kittengineering/MJS2020/Documents/Blockdiagram_MJS_Rev4.pdf

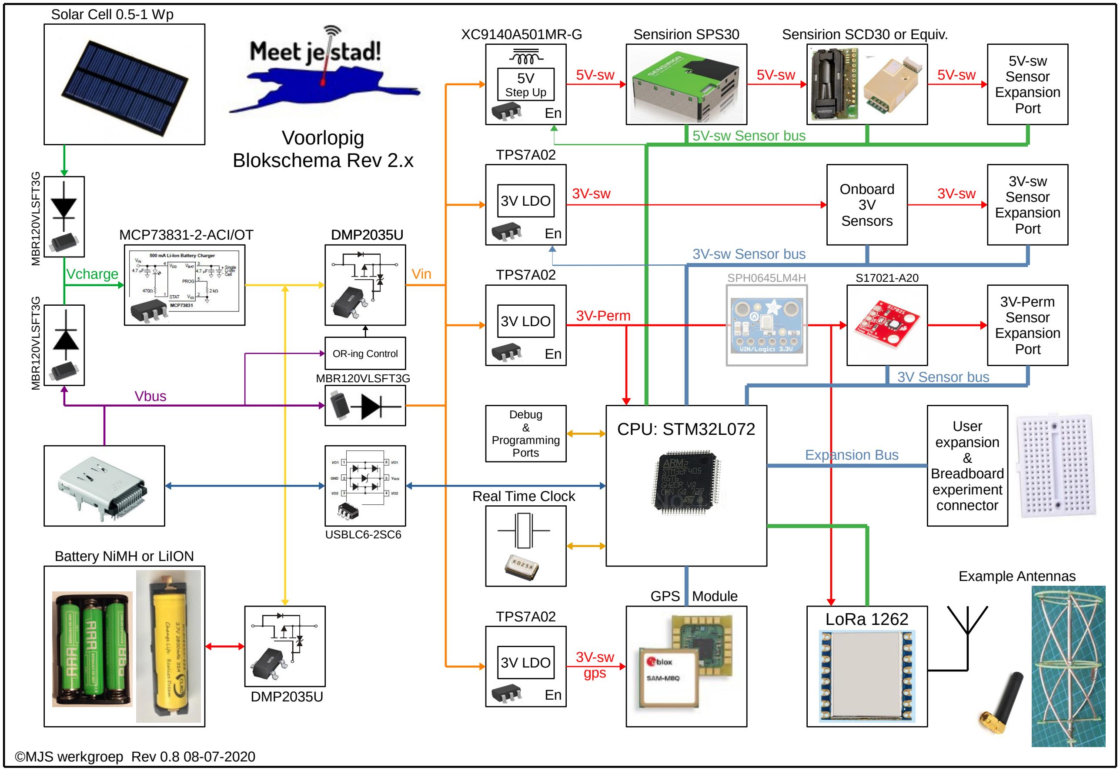
[picture p2: figure]
3V-Perm Sensor Expansion; OR-ing Control; Port; Vbus; Vcharge; Vin; 3V LDO; 5V Step Up; CPU: STM32L072; 3V-sw gps; 5V-sw Sensor Expansion Port; 5V-sw Sensor bus; 3V-sw Sensor Expansion Port; Onboard 3V Sensors; 3V-Perm; LoRa 1262; User expansion & Breadboard experiment connector; 3V-sw Sensor bus; 3V Sensor bus; Expansion Bus; Example Antennas; Real Time Clock; GPS; Module; TPS7A02; Battery NiMH or LiION; Solar Cell 0.5-1 Wp; MCP73831-2-ACI/OT; DMP2035U; MBR120VLSFT3G; USBLC6-2SC6; Sensirion SPS30; Sensirion SCD30 or Equiv.; Debug & Programming Ports; SPH0645LM4H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
