kittengineering/MJS2020/Documents/BoardMJS2020.png

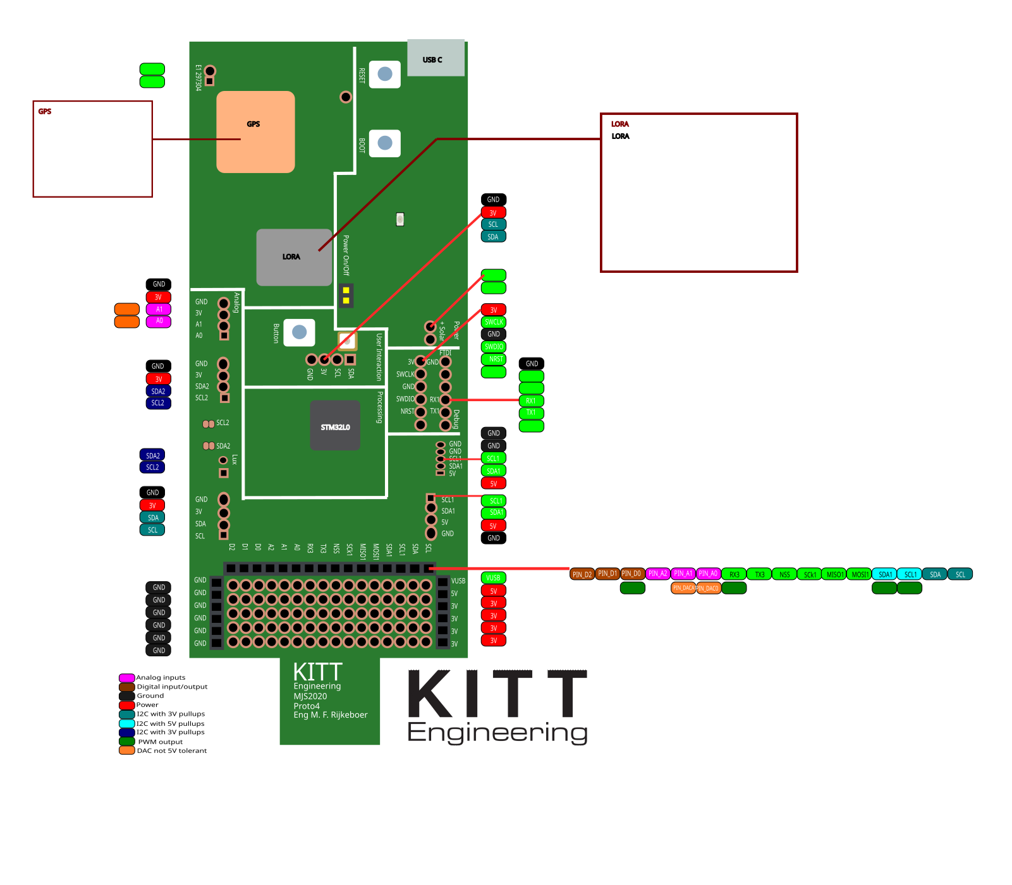
Documents/BoardMJS2020.png
