kittengineering/MJS2020/MJS2020.jpg

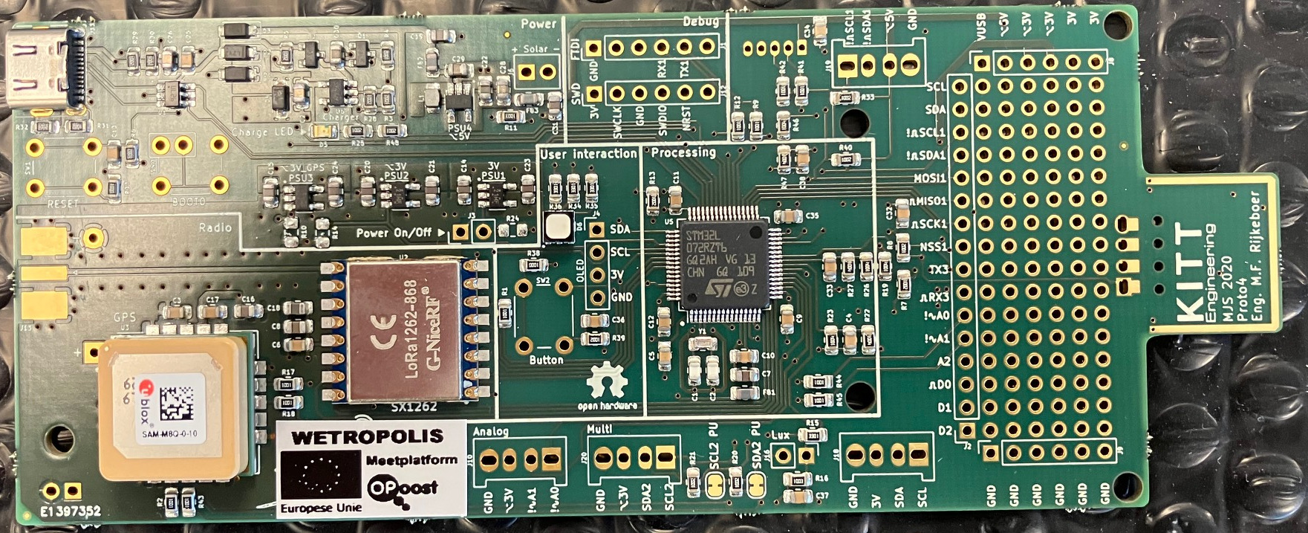
MJS2020.jpg
