kittengineering/MJS2020/Documents/MJS_PROTO3_PROTO4_Schematic.pdf

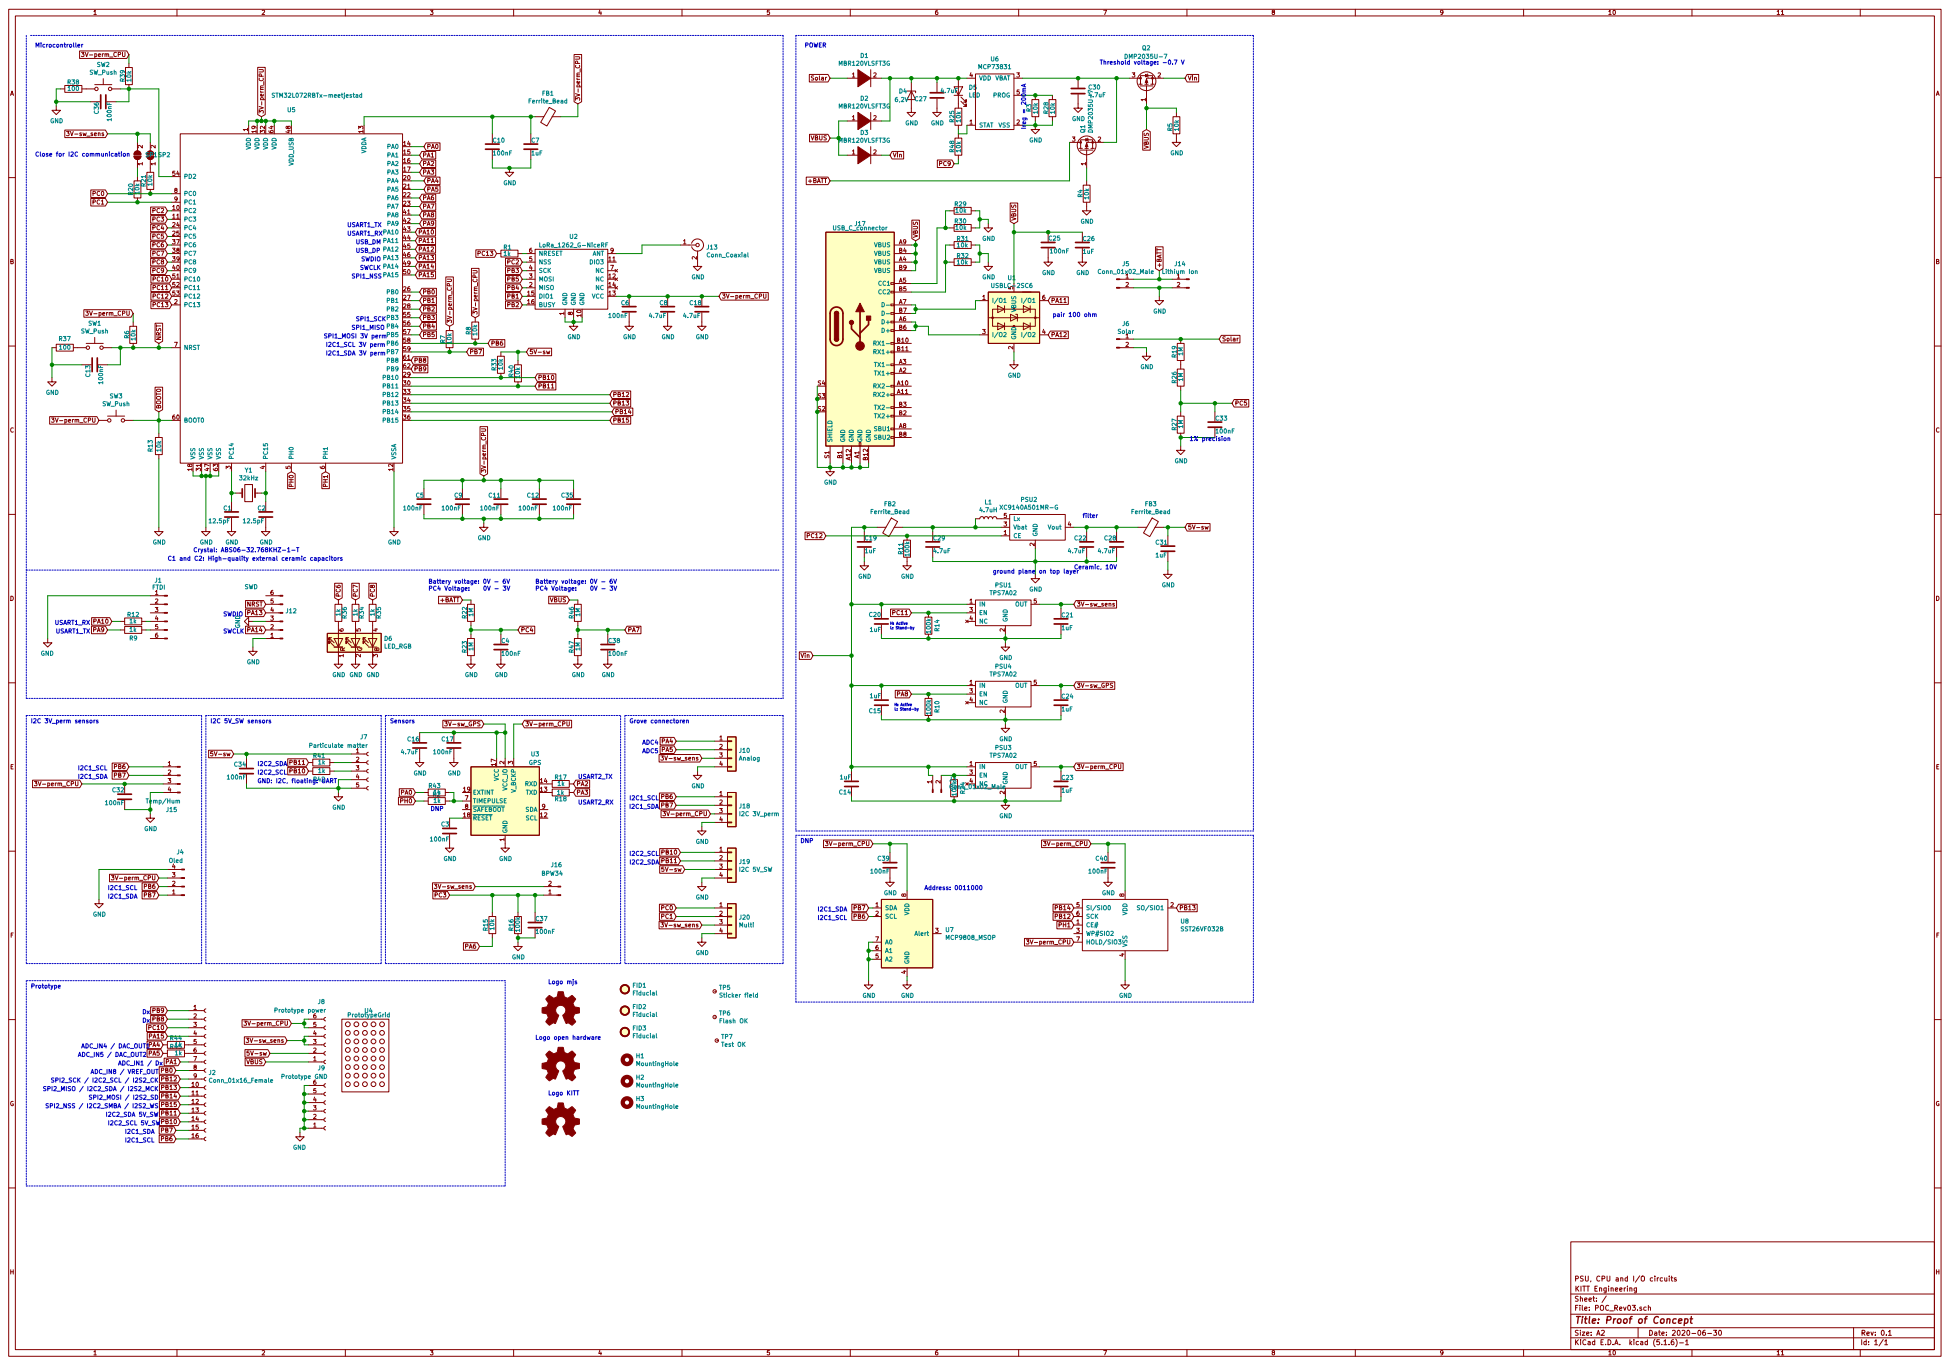
[picture p5: page 1]

PSU, CPU and I/O circuits R47 1M

File: POC_Rev03.sch Sheet: / KITT Engineering

Id: 1/1 Title: Proof of Concept
