kittengineering/MJS2020/Documents/PCB_Layout_Commented_Rev4.pdf

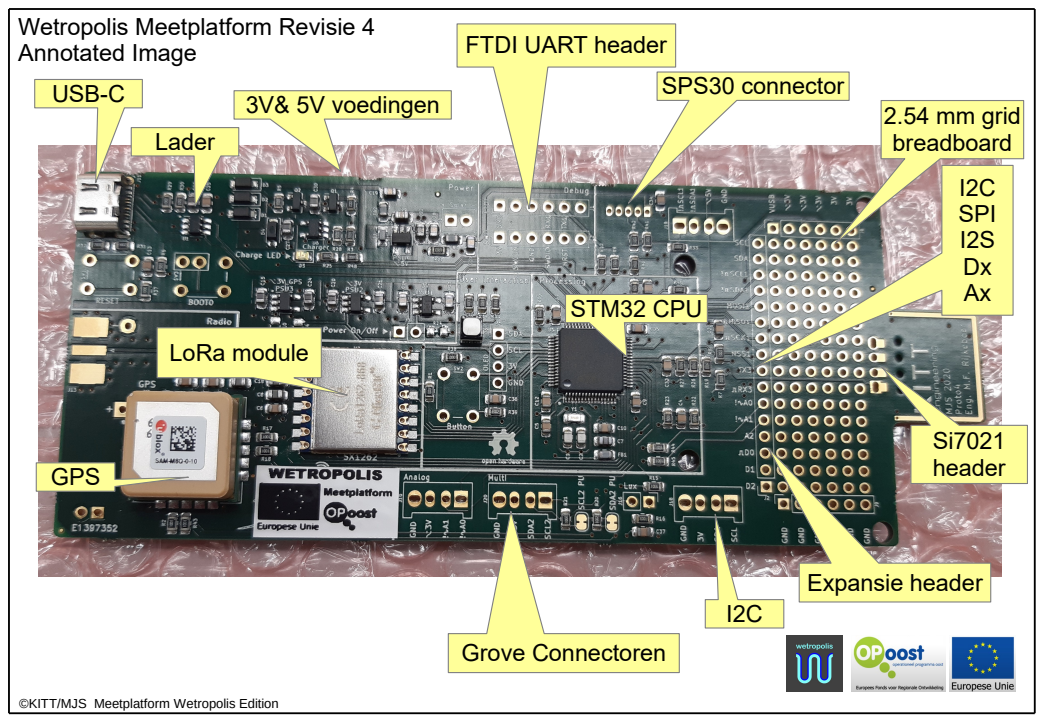
[picture p6: page 1]
Grove Connectoren; Expansie header; STM32 CPU; GPS; LoRa module; Lader; 3V& 5V voedingen; SPS30 connector; 2.54 mm grid breadboard; Si7021 header; I2C SPI I2S Dx Ax

Wetropolis Meetplatform Revisie 4
Annotated Image
USB-C

FTDI UART header

©KITT/MJS Meetplatform Wetropolis Edition
