kittengineering/MJS2020/Hardware/MJS2020.kicad_pcb

## KiCad design Hardware/MJS2020.kicad_pcb (2022-10-26)

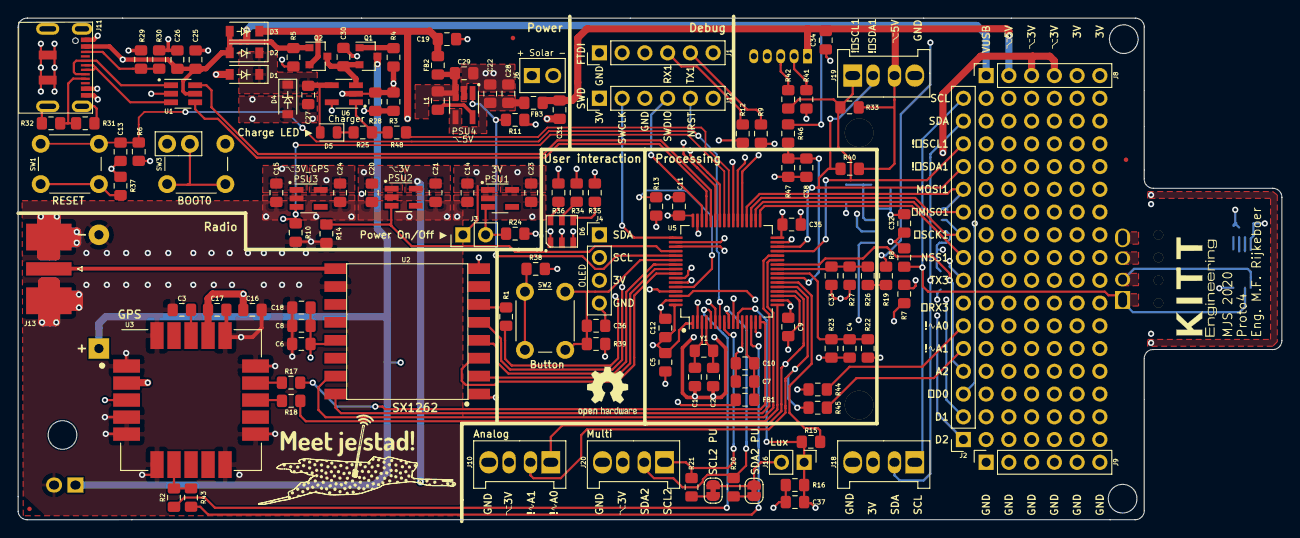
[picture p7: board MJS2020.kicad_pcb from above]

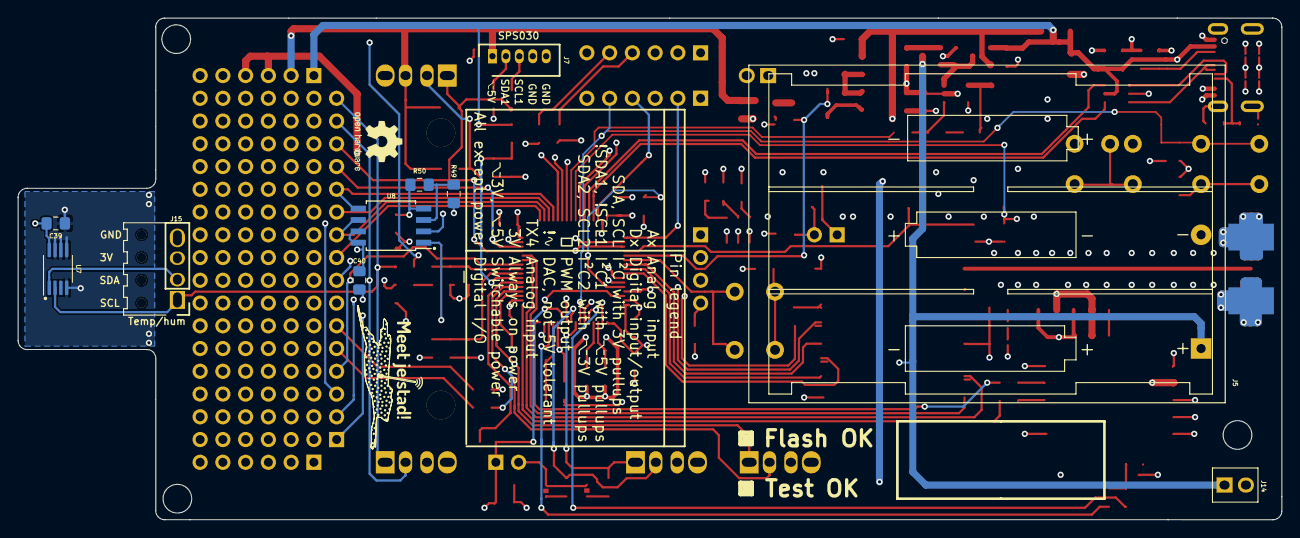
[picture p8: board MJS2020.kicad_pcb from below]

Board: 4 copper layers, 141.1 x 56.0 mm, 153 parts (15 on the bottom side), 98 nets.

Parts:
C1, C2: 12.5pF; C_0805_2012Metric_Pad1.15x1.40mm_HandSolder
C3, C4, C5, C6, C9, C10, C11, C12, C13, C17, C25, C32, C33, C34, C35, C36, C37, C38, C39, C40: 100nF; C_0805_2012Metric_Pad1.15x1.40mm_HandSolder
C7, C14, C15, C19, C20, C21, C23, C24, C26, C31: 1uF; C_0805_2012Metric_Pad1.15x1.40mm_HandSolder
C8, C16, C18, C22, C27, C28, C29, C30: 4.7uF; C_0805_2012Metric_Pad1.15x1.40mm_HandSolder
D1, D2, D3: MBR120VLSFT3G; Diode_SMD-SOD_123
D4: 6,2V; D_SOD-123
D5: LED; LED_0805_2012Metric
D6: LED_RGB; JTS3535
FB1, FB2, FB3: Ferrite_Bead; R_0805_2012Metric_Pad1.15x1.40mm_HandSolder
FID1, FID2, FID3: Fiducial; Fiducial_0.5mm_Mask1mm
H1, H2, H3: MountingHole; MountingHole_3.2mm_M3
J1: FTDI; PinHeader_1x06_P2.54mm_Vertical
J2: Conn_01x16_Female; PinHeader_Female_1X16
J3: Conn_01x02_Male; PinHeader_Male_1X2
J4: Oled; OLED_1.3
J5: Conn_01x02_Male; Battery__holder
J6: Solar; Combi_2.0_2.45pitch_2PIN
J7: Particulate matter; B5B-ZR
J8: Prototype power; PinHeader_Female_1X6
J9: Prototype GND; PinHeader_Female_1X6
J10: Analog; 2,54_2.0pitchCombi
J11: USBC(2.0); DX07S016JA3R1500
J12: SWD; PinHeader_1x06_P2.54mm_Vertical
J13: Conn_Coaxial; SMA connector edge mount
J14: Lithium Ion; Combi_2.0_2.45pitch_2PIN
J15: Temp/Hum; SI7021
J16: BPW34; PinHeader_Male_1X2
J18: I2C 3V_perm; 2,54_2.0pitchCombi
J19: I2C 5V_SW; 2,54_2.0pitchCombi
J20: Multi; 2,54_2.0pitchCombi
L1: 4.7uH; R_0805_2012Metric_Pad1.15x1.40mm_HandSolder
Logo_kitt1: Logo_Open_Hardware_Small; Kitt_logo
Logo_mjs1: Logo_Open_Hardware_Small; mjs-logo-16mm
Logo_mjs2, Logo_mjs4: Logo_Open_Hardware_Small; OSHW-Logo2_7.3x6mm_SilkScreen
Logo_mjs3: Logo_Open_Hardware_Small; mjs-logo-22mm
PSU1, PSU2, PSU3: TPS7A02; SOT-23-5_HandSoldering
PSU4: XC9140A501MR-G; SOT-23-5_HandSoldering
Q1, Q2: DMP2035U-7; SOT-23
R1, R2, R9, R12, R17, R18, R41, R42, R43, R44, R45: 1k; R_0805_2012Metric_Pad1.15x1.40mm_HandSolder
R3, R4, R5, R6, R7, R8, R13, R20, R21, R25, R28, R29, R30, R31, R32, R33, R39, R40, R48, R49, R50: 10k; R_0805_2012Metric_Pad1.15x1.40mm_HandSolder
R10, R11, R14, R16, R24: 100k; R_0805_2012Metric_Pad1.15x1.40mm_HandSolder
R15, R34, R35, R36: 3k3; R_0805_2012Metric_Pad1.15x1.40mm_HandSolder
R19, R22, R23, R26, R27, R46, R47: 1M; R_0805_2012Metric_Pad1.15x1.40mm_HandSolder
R37, R38: 100; R_0805_2012Metric_Pad1.15x1.40mm_HandSolder
SP1, SP2: SolderJumper_2_Open; SolderJumper-2_P1.3mm_Bridged_RoundedPad1.0x1.5mm
SW1, SW2: SW_Push; SW_Push_6mm
SW3: SW_Push; Switch_Header2.54_Combi
TP5: Sticker field
TP6: Flash OK
TP7: Test OK
U1: USBLC-2SC6; SOT-23-6_Handsoldering
U2: LoRa_1262_G-NiceRF
U3: GPS; GPS_ublox-SAM-M8Q
U4: PrototypeGrid; Prototype grid
U5: STM32L072RZTx-meetjestad; STM32F072_LQFP-64
U6: MCP73831; SOT-23-5_HandSoldering
U7: MCP9808_MSOP; MSOP-8_3x3mm_P0.65mm
U8: SST26VF032B; SOIJ-8_5.3x5.3mm_P1.27mm
Y1: 32kHz; R_0805_2012Metric_Pad1.15x1.40mm_HandSolder

Connections:
3V-perm_CPU: C5.1, C6.1, C8.1, C9.1, C11.1, C12.1, C18.1, C23.1, C32.2, C35.1, C39.2, C40.2, FB1.1, J4.3, J8.5, J8.6, J12.1, J15.3, J18.3, PSU1.5, R6.1, R7.2, R8.2, R39.1, R49.1, SW3.1, U2.13, U3.3, U5.1, U5.19, U5.32, U5.48, U5.64, U7.8, U8.7, U8.8
3V-sw_GPS: C16.1, C17.1, C24.1, PSU3.5, U3.2, U3.17
3V-sw_sens: C21.1, J8.3, J8.4, J10.3, J16.2, J20.3, PSU2.5, SP1.2, SP2.2
5V-sw: C31.1, C34.2, FB3.1, J7.1, J8.2, J19.3, R33.2, R40.2
+BATT: J5.1, J14.1, Q1.3, R22.1
BOOT0: R13.1, SW3.2, U5.60
GND: C1.2, C2.2, C3.1, C4.2, C5.2, C6.2, C7.2, C8.2, C9.2, C10.2, C11.2, C12.2, C13.2, C14.1, C15.1, C16.2, C17.2, C18.2, C19.2, C20.1, C21.2, C22.2, C23.2, C24.2, C25.1, C26.2, C27.1, C28.2, C29.2, C30.2, C31.2, C32.1, C33.2, C34.1, C35.2, C36.2, C37.2, C38.2, C39.1, C40.1, D4.2, D6.1, D6.2, D6.3, J1.1, J4.4, J5.2, J6.2, J7.4, J7.5, J9.1, J9.2, J9.3, J9.4, J9.5, J9.6, J10.4, J11.1, J11.12, J11.S, J12.3, J13.2, J14.2, J15.4, J18.4, J19.4, J20.4, PSU1.2, PSU2.2, PSU3.2, PSU4.2, R3.2, R4.2, R5.2, R10.2, R11.2, R13.2, R14.2, R16.1, R23.2, R24.2, R27.2, R28.2, R29.2, R30.2, R31.1, R32.1, R37.1, R38.1, R47.2, R50.2, U1.2, U2.1, U2.8, U2.10, U3.1, U3.4, U3.5, U3.6, U3.10, U3.11, U3.15, U3.16, U3.20, U5.12, U5.18, U5.31, U5.47, U5.63, U6.2, U7.4, U7.5, U7.6, U7.7, U8.4
NRST: C13.1, J12.5, R6.2, SW1.2, U5.7
unnamed: C1.1, U5.3, Y1.1
unnamed: C2.1, U5.4, Y1.2
unnamed: C3.2, U3.18
unnamed: C7.1, C10.1, FB1.2, U5.13
unnamed: C22.1, C28.1, FB3.2, PSU4.4
unnamed: C27.2, D1.2, D2.2, D4.1, D5.2, U6.4
unnamed: C29.1, FB2.1, L1.1, PSU4.3
unnamed: C30.1, Q1.2, Q2.3, U6.3
unnamed: C36.1, R39.2, SW2.2, U5.54
unnamed: D5.1, R25.1
unnamed: D6.4, R35.1
unnamed: D6.5, R34.1
unnamed: D6.6, R36.1
unnamed: J1.4, R12.1
unnamed: J1.5, R9.1
unnamed: J2.5, R45.2
unnamed: J2.6, R44.2
unnamed: J3.2, PSU1.3, R24.1
unnamed: J7.2, R41.2
unnamed: J7.3, R42.2
unnamed: J11.3, R29.1, R30.1
unnamed: J11.5, J11.8, U1.1
unnamed: J11.6, J11.7, U1.3
unnamed: J11.9, R31.2, R32.2
unnamed: J13.1, U2.9
unnamed: L1.2, PSU4.5
unnamed: Q1.1, R4.1
unnamed: R1.1, U2.6
unnamed: R2.2, R43.2, U3.7
unnamed: R17.1, U3.14
unnamed: R18.2, U3.13
unnamed: R19.2, R26.1
unnamed: R20.2, SP1.1
unnamed: R21.2, SP2.1
unnamed: R25.2, R48.1, U6.1
unnamed: R3.1, R28.1, U6.5
unnamed: R37.2, SW1.1
unnamed: R38.2, SW2.1
unnamed: R49.2, R50.1, U8.3
PA0: R43.1, U5.14
PA1: J2.7, U5.15
PA2: R17.2, U5.16
PA3: R18.1, U5.17
PA4: J10.1, R44.1, U5.20
PA5: J10.2, R45.1, U5.21
PA6: R15.1, U5.22
PA7: C38.1, R46.2, R47.1, U5.23
PA8: PSU3.3, R10.1, U5.41
PA9: R9.2, U5.42
PA10: R12.2, U5.43
PA11: U1.6, U5.44
PA12: U1.4, U5.45
PA13: J12.4, U5.46
PA14: J12.2, U5.49
PA15: J2.3, U5.50
PB0: J2.4, U5.26
PB1: U2.15, U5.27
PB2: U2.16, U5.28
PB3: U2.4, U5.55
PB4: U2.2, U5.56
PB5: U2.3, U5.57
PB6: J2.16, J4.2, J15.1, J18.1, R8.1, U5.58, U7.2
PB7: J2.15, J4.1, J15.2, J18.2, R7.1, U5.59, U7.1
PB8: J2.2, U5.61
PB9: J2.1, U5.62
PB10: J2.14, J19.1, R33.1, R42.1, U5.29
PB11: J2.13, J19.2, R40.1, R41.1, U5.30
PB12: J2.9, U5.33
PB13: J2.10, U5.34, U8.6
PB14: J2.11, U5.35, U8.2
PB15: J2.12, U5.36, U8.5
PC0: J20.1, R21.1, U5.8
PC1: J20.2, R20.1, U5.9
PC2: U2.5, U5.10
PC3: C37.1, J16.1, R15.2, R16.2, U5.11
PC4: C4.1, R22.2, R23.1, U5.24
PC5: C33.1, R26.2, R27.1, U5.25
PC6: R36.2, U5.37
PC7: R34.2, U5.38
PC8: R35.2, U5.39
PC9: R48.2, U5.40
PC10: J2.8, U5.51
PC11: PSU2.3, R14.1, U5.52
PC12: PSU4.1, R11.1, U5.53
PC13: R1.2, U5.2
PH0: R2.1, U5.5
PH1: U5.6, U8.1
Solar: D1.1, J6.1, R19.1
VBUS: C25.2, C26.1, D2.1, D3.1, J8.1, J11.2, J11.11, Q2.1, R5.1, R46.1, U1.5
Vin: C14.2, C15.2, C19.1, C20.2, D3.2, FB2.2, J3.1, PSU1.1, PSU2.1, PSU3.1, Q2.2
