kittengineering/MJS2020/Software/MJSV4_Basic_sketch_LoRa_TTN_OTAA/basicmac-otaa/basicmac-otaa.ino

/*******************************************************************************
 * Copyright (c) 2015 Thomas Telkamp and Matthijs Kooijman
 *
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
 * This example sends a valid LoRaWAN packet with payload "Hello,
 * world!", using frequency and encryption settings matching those of
 * the The Things Network.
 *
 * This uses OTAA (Over-the-air activation), where a DevEUI and
 * application key is configured separatly in the ttn.config.keys.h
 * file, which are used in an over-the-air
 * activation procedure where a DevAddr and session keys are
 * assigned/generated for use with all further communication.
 *
 * Note: LoRaWAN per sub-band duty-cycle limitation is enforced (1% in
 * g1, 0.1% in g2), but not the TTN fair usage policy (which is probably
 * violated by this sketch when left running for longer)!

 * To use this sketch, first register your application and device with
 * the things network, to set or generate an AppEUI, DevEUI and AppKey.
 * Multiple devices can use the same AppEUI, but each device has its own
 * DevEUI and AppKey. These keys can be entered in the ttn-config-keys.h.
 *
 * Do not forget to define the radio type correctly in config.h.
 * 
 * This sketch needs the basicmac library 
 * from https://github.com/LacunaSpace/basicmac
 *
 *******************************************************************************/

#include <basicmac.h>
#include <hal/hal.h>
#include <SPI.h>

// keys for TTN have been moved to another file
// DO NOT COMMIT THE ttn-config-keys.h FILE BACK TO GIT!
// AS EVERYBODEY WILL HAVE ACCESS TO YOUR KEYS!
#include "ttn-config-keys.h"

// Schedule TX every this many milliseconds (might become longer due to duty
// cycle limitations).
const unsigned TX_INTERVAL = 60000;

// Timestamp of last packet sent
uint32_t last_packet = 0;

//some definitions need to be converted for basicmac
#define os_getArtEui os_getJoinEui
#define os_getDevKey os_getNwkKey
#define onEvent onLmicEvent
#define os_runloop_once os_runstep
#define OS_INIT_ARG nullptr
#define DR_SF12 0
#define DR_SF9 3

// Pin out for the MJS2020 Proto4 board
const lmic_pinmap lmic_pins = {
  .nss = PIN_LORA_SS,
  .tx = LMIC_CONTROLLED_BY_DIO2,
  .rx = LMIC_UNUSED_PIN,
  .rst = PIN_LORA_RST,
  .dio = {/* DIO0 */ LMIC_UNUSED_PIN, /* DIO1 */ PIN_LORA_DIO1, /* DIO2 */ LMIC_UNUSED_PIN},
  .busy = PIN_LORA_BUSY,
  .tcxo = LMIC_CONTROLLED_BY_DIO3,
};

void onLmicEvent (ev_t ev) {
    Serial.print(os_getTime());
    Serial.print(": ");
    switch(ev) {
        case EV_SCAN_TIMEOUT:
            Serial.println(F("EV_SCAN_TIMEOUT"));
            break;
        case EV_BEACON_FOUND:
            Serial.println(F("EV_BEACON_FOUND"));
            break;
        case EV_BEACON_MISSED:
            Serial.println(F("EV_BEACON_MISSED"));
            break;
        case EV_BEACON_TRACKED:
            Serial.println(F("EV_BEACON_TRACKED"));
            break;
        case EV_JOINING:
            Serial.println(F("EV_JOINING"));
            break;
        case EV_JOINED:
            Serial.println(F("EV_JOINED"));

            // Disable link check validation (automatically enabled
            // during join, but not supported by TTN at this time).
            LMIC_setLinkCheckMode(0);
            break;
        case EV_RFU1:
            Serial.println(F("EV_RFU1"));
            break;
        case EV_JOIN_FAILED:
            Serial.println(F("EV_JOIN_FAILED"));
            break;
        case EV_REJOIN_FAILED:
            Serial.println(F("EV_REJOIN_FAILED"));
            break;
            break;
        case EV_TXCOMPLETE:
            Serial.println(F("EV_TXCOMPLETE (includes waiting for RX windows)"));
            if (LMIC.txrxFlags & TXRX_ACK)
              Serial.println(F("Received ack"));
            if (LMIC.dataLen) {
              Serial.print(F("Received "));
              Serial.print(LMIC.dataLen);
              Serial.println(F(" bytes of payload"));
            }
            break;
        case EV_LOST_TSYNC:
            Serial.println(F("EV_LOST_TSYNC"));
            break;
        case EV_RESET:
            Serial.println(F("EV_RESET"));
            break;
        case EV_RXCOMPLETE:
            // data received in ping slot
            Serial.println(F("EV_RXCOMPLETE"));
            break;
        case EV_LINK_DEAD:
            Serial.println(F("EV_LINK_DEAD"));
            break;
        case EV_LINK_ALIVE:
            Serial.println(F("EV_LINK_ALIVE"));
            break;
        case EV_SCAN_FOUND:
            Serial.println(F("EV_SCAN_FOUND"));
            break;
        case EV_TXSTART:
            Serial.println(F("EV_TXSTART"));
            break;
        case EV_TXDONE:
            Serial.println(F("EV_TXDONE"));
            break;
        case EV_DATARATE:
            Serial.println(F("EV_DATARATE"));
            break;
        case EV_START_SCAN:
            Serial.println(F("EV_START_SCAN"));
            break;
        case EV_ADR_BACKOFF:
            Serial.println(F("EV_ADR_BACKOFF"));
            break;

         default:
            Serial.print(F("Unknown event: "));
            Serial.println(ev);
            break;
    }
}

void setup() {
    Serial.begin(115200);

    // Wait up to 5 seconds for serial to be opened, to allow catching
    // startup messages on native USB boards (that do not reset when
    // serial is opened).
    unsigned long start = millis();
    while (millis() - start < 5000 && !Serial);

    Serial.println();
    Serial.println();
    Serial.println(F("Starting"));
    Serial.println();

    // LMIC init
    os_init(nullptr);
    LMIC_reset();

    // Enable this to increase the receive window size, to compensate
    // for an inaccurate clock.  // This compensate for +/- 10% clock
    // error, a lower value will likely be more appropriate.
    //LMIC_setClockError(MAX_CLOCK_ERROR * 10 / 100);

    // Start join
    LMIC_startJoining();

    // Make sure the first packet is scheduled ASAP after join completes
    last_packet = millis() - TX_INTERVAL;

    // Optionally wait for join to complete (uncomment this is you want
    // to run the loop while joining).
    while ((LMIC.opmode & (OP_JOINING)))
        os_runstep();
}

void loop() {
    // Let LMIC handle background tasks
    os_runstep();

    // If TX_INTERVAL passed, *and* our previous packet is not still
    // pending (which can happen due to duty cycle limitations), send
    // the next packet.
    if (millis() - last_packet > TX_INTERVAL && !(LMIC.opmode & (OP_JOINING|OP_TXRXPEND)))
        send_packet();
}

void send_packet(){
    // Prepare upstream data transmission at the next possible time.
    uint8_t mydata[] = "Hello, world!";
    LMIC_setTxData2(1, mydata, sizeof(mydata)-1, 0);
    Serial.println(F("Packet queued"));

    last_packet = millis();
}
