kittengineering/MJS2020/Software/MJSV4_Basic_sketch_LoRa_TTN_OTAA/basicmac-otaa/ttn-config-keys.h

// keys for TTN have been moved to another file
// DO NOT COMMIT THE ttn-config-keys.h FILE BACK TO GIT!
// AS EVERYBODEY WILL HAVE ACCESS TO YOUR KEYS!

// This EUI must be in little-endian format, so least-significant-byte
// first. When copying an EUI from ttnctl output, this means to reverse
// the bytes. For TTN issued EUIs the last bytes should be 0xD5, 0xB3,
// 0x70.
static const u1_t PROGMEM APPEUI[8]={ 0xFF, 0x00, 0x00, 0x00, 0x00, 0x00, 0x00, 0x00 };
void os_getJoinEui (u1_t* buf) { memcpy_P(buf, APPEUI, 8);}

// This should also be in little endian format, see above.
static const u1_t PROGMEM DEVEUI[8]={ 0x00, 0x00, 0x00, 0x00, 0x00, 0x00, 0x00, 0x00 };
void os_getDevEui (u1_t* buf) { memcpy_P(buf, DEVEUI, 8);}

// This key should be in big endian format (or, since it is not really a
// number but a block of memory, endianness does not really apply). In
// practice, a key taken from ttnctl can be copied as-is.
// The key shown here is the semtech default key.
static const u1_t PROGMEM APPKEY[16] = { 0x00, 0x00, 0x00, 0x00, 0x00, 0x00, 0x00, 0x00, 0x00, 0x00, 0x00, 0x00, 0x00, 0x00, 0x00, 0x00 };
void os_getNwkKey (u1_t* buf) {  memcpy_P(buf, APPKEY, 16);}

// The region to use, this just uses the first one (can be changed if
// multiple regions are enabled).
u1_t os_getRegion (void) { return LMIC_regionCode(0); }
