kittengineering/MJS2020/(commit log)

2022-09-29 Pictures of the MJS2020 platform
    One image showing the bare board, another one with an oled screen and a humidity and temperature sensor.
2022-09-29 Added the board image with OLED and sensor
2022-10-13 Update README.md
    Described: Arduino IDE sometimes can't find a port, but you can ignore this.
2022-10-25 Update README.md
    Selected the right board
2022-10-26 Update README.md
    added link to board sourcefiles repository
2022-10-26 Added kicad board file
    [MJS2020.kicad_pcb]
2022-10-26 Update README.md
    Moved the lora desciption and clarified installing arduino IDE
2022-10-27 Board schematic
2022-10-31 LoRAKey.h added to gitignore and some tweaking on the Board layout
2022-10-31 Board layout and IO pins description added
    [IO_MJS2020.ods]
2022-10-31 added the board layout update
2022-10-31 Update README.md
    Board layout moved from .png to .svg file
2022-10-31 added the board layout update: now with white background
2022-10-31 Overview of the code hooks
    [IO_MJS2020.ods]
